Bouhafs-Aek/antenna-agent/examples/ti_pcb_antennas/README.md

# TI PCB antennas traced for KiCad (from the application notes)

Generated by `python scripts/ti_antennas.py examples/ti_pcb_antennas` (needs `pip install shapely matplotlib`). Each folder: `<name>.kicad_pcb`, Gerber `-F_Cu / -B_Cu / -Edge_Cuts`, `preview.png`.
The copper is the dimension table + figure of the note, rectangle by rectangle (see the top of `scripts/ti_antennas.py`). **TI itself says an exact copy needs its own Gerber/DXF from the reference design
(not provided): overlay TI's file on these before ordering; the dimensions here were read off the figures and tables and checked only by eye against the figure.**

| Folder | Note | Antenna | Substrate | Size (mm) | Main dimensions used |
|---|---|---|---|---|---|
| `an043_ifa_2g4` | AN043 (SWRA117D) | small meandered IFA, 2.4 GHz, VSWR < 2 over the ISM band (per the note) | thickness NOT given in the note (1.0 mm placeholder) | 15.2 x 5.7 (+ 20 mm ground placeholder) | L1 3.94 L2 2.70 L3 5.00 L4 2.64 L5 2.00 L6 4.90 W1 0.90 W2 0.50 D1 0.50 D2 0.30 D3 0.30 D4 0.50 D5 1.40 D6 1.70; ground on layer 2 |
| `dn023_ifa_868` | DN023 (SWRA228C) | inverted-F, 868 / 915 / 955 MHz | FR4 0.8 mm | board 45 x 31 ground + antenna 43 x 20 | L1 20 L2 5 L3 4 L4 10 L5 6 L6 17 (868: 9, 915: 1) L7 43 X 31 Y 45 W 1 W2 2; shorted leg + feed leg with a 1 mm gap to the ground (pi-network pads) |
| `dn024_mono_868` | DN024 (SWRA227E) | meandering monopole, 868 / 915 / 920 MHz or dual band 868 + 2440 MHz | FR4 1.6 mm | board 43 x 88 | L1 9 L2 18 L3 3 L4 38 L5 1 W 2 X1 63 X2 25 Y 43; copper on both layers |
| `an730_mono_bom` | SWRA730 | BOM-tunable meander monopole, 433-510 or 868-930 MHz, optionally + 2.4 GHz | FR4 1.6 mm | antenna 43 x 25, ground 30 mm placeholder | L1 16 L2 2 L3 24 L4 38 L5 7 L6 1.4 L7 3 W 2; Z64 gap (L2) bridged by 0 ohm copper |

Not in the traced set: the **AN058 (SWRA161B)** selection guide gives no dimension tables (it lists the reference designs; the Gerbers are in TI's reference-design zips).

## What is in each KiCad file
- Copper as zones with nets RF / GND (DN024, SWRA730) or as unnetted graphic copper polygons (AN043, DN023: the shorted leg ties RF and GND together in copper, so nets would be false).
- Lumped-port footprint `PORT_P1` (pad 1 RF on F.Cu, pad 2 GND): across the 1 mm gap to the ground edge (DN023, DN024), 1.4 mm (SWRA730), or on the feed pad over ground layer 2 (AN043).
- Edge.Cuts outline, stackup thickness in the file header, a note on the Cmts.User layer.

## Assumptions to check (not in the notes or read from a figure)
- AN043: PCB thickness, ground size, via position/size (0.6 / 0.3 mm placeholder under the via pad).
- DN023 / DN024 / SWRA730: ground-plane size below the antenna is a placeholder except DN023 (31 x 45) and DN024 (63 x 43, from the note). The CPW feed pocket and the pi/LC match (Z60-Z64) are not drawn; place the parts from the note.
- Bottom-layer copies of DN024 / SWRA730 are joined to the top by 2 placeholder vias (positions are my guess: the notes say only that the antenna is on both layers).
- Spacings in DN023's meander read from the figure at about +-0.5 mm; pitch 5.0 mm between legs, leg width 1.0 mm.
- None of these files was opened in KiCad or simulated here.
