Bouhafs-Aek/antenna-agent/docs/REFERENCE.md

# Reference paper

The antenna rebuilt and validated in this repository is the work of **Mohamed M. Gad and Mai O. Sallam**. This project
reproduces it for software validation; the antenna design is theirs. Please cite the paper if you use these examples.

**APA**
Gad, M. M., & Sallam, M. O. (2024). High gain antipodal meander line antenna for point-to-point WLAN/WiMAX applications. *Scientific Reports, 14*, 5769. https://doi.org/10.1038/s41598-024-54994-x

**BibTeX**
```bibtex
@article{gad2024meander,
  author  = {Gad, Mohamed M. and Sallam, Mai O.},
  title   = {High gain antipodal meander line antenna for point-to-point WLAN/WiMAX applications},
  journal = {Scientific Reports},
  volume  = {14},
  pages   = {5769},
  year    = {2024},
  doi     = {10.1038/s41598-024-54994-x},
  note    = {Open access, CC BY 4.0}
}
```

The paper is open access under CC BY 4.0 (https://creativecommons.org/licenses/by/4.0/). The unmodified PDF is in
`examples/gad_meander_replica/paper/`. Simulated numbers in this repository come from HFSS Student, not from the authors' data;
published values quoted here (band, directivity, measured gain) are theirs.

# Second reference: TI AN043 (IFA example)

A. Andersen, *Small Size 2.4 GHz PCB antenna*, Texas Instruments Application Note AN043, SWRA117D, 2008.
The antenna is TI's design (CC2511 USB dongle reference design). The PDF is not redistributed here.
```bibtex
@techreport{andersen2008an043,
  author      = {Andersen, Audun},
  title       = {Small Size 2.4 GHz PCB antenna},
  institution = {Texas Instruments},
  type        = {Application Note},
  number      = {AN043 (SWRA117D)},
  year        = {2008}
}
```
