Bouhafs-Aek/antenna-agent/examples/gad_meander_replica/results/report/report.html

# Report: examples

S11 minimum | -27.4 dB at 2.455 GHz
S11 < -10 dB band | 2.155-2.695 GHz
Worst S11 in 2.2-2.7 GHz | -9.1 dB at 2.700 GHz
Max VSWR in 2.2-2.7 GHz | 2.08
Input impedance at 2.450 GHz | 48 - 4j ohm
Gain at 2.2 GHz | 8.1 dBi (realised 7.8 dBi), peak at Theta 90 deg, Phi 82 deg
Gain at 2.45 GHz | 9.6 dBi (realised 9.6 dBi), peak at Theta 90 deg, Phi 90 deg
Gain at 2.7 GHz | 10.8 dBi (realised 10.3 dBi), peak at Theta 90 deg, Phi 90 deg
Radiation | patterns.csv missing: re-run the simulation with the current hfss_build.py

## S11 (dB)

## VSWR

## Input impedance

## Gain
