Bouhafs-Aek/antenna-agent/examples/gad_meander_b3_ro3003/s096/results/report/report.html

# Report: gad_meander_b3_ro3003

S11 minimum | -19.7 dB at 1.860 GHz
S11 < -10 dB band | 1.662-1.947 GHz ; 2.019-2.061 GHz
Worst S11 in 1.71-1.88 GHz | -10.6 dB at 1.710 GHz
Max VSWR in 1.71-1.88 GHz | 1.84
Input impedance at 1.794 GHz | 39 - 14j ohm
Gain at 1.71 GHz | 8.6 dBi (realised 8.2 dBi), peak at Theta 90 deg, Phi 82 deg
Gain at 1.795 GHz | 9.3 dBi (realised 9.1 dBi), peak at Theta 88 deg, Phi 88 deg
Gain at 1.88 GHz | 9.6 dBi (realised 9.6 dBi), peak at Theta 90 deg, Phi 90 deg
-3 dB beamwidth at 1.71 GHz (YZ / XY plane) | 94 deg / 58 deg
-3 dB beamwidth at 1.795 GHz (YZ / XY plane) | 86 deg / 56 deg
-3 dB beamwidth at 1.88 GHz (YZ / XY plane) | 80 deg / 54 deg

## S11 (dB)

## VSWR

## Input impedance

## Gain

## Radiation patterns (cuts)

## Gain over the whole sphere
