Bouhafs-Aek/antenna-agent/examples/gad_meander_b3_ro3003/s100/results/report/report.html

# Report: gad_meander_b3_ro3003

S11 minimum | -16.6 dB at 1.797 GHz
S11 < -10 dB band | 1.620-1.632 GHz ; 1.650-1.878 GHz ; 1.983-1.992 GHz
Worst S11 in 1.71-1.88 GHz | -10.1 dB at 1.878 GHz
Max VSWR in 1.71-1.88 GHz | 1.91
Input impedance at 1.794 GHz | 45 - 13j ohm
Gain at 1.71 GHz | 9.0 dBi (realised 8.8 dBi), peak at Theta 90 deg, Phi 88 deg
Gain at 1.795 GHz | 9.4 dBi (realised 9.3 dBi), peak at Theta 90 deg, Phi 90 deg
Gain at 1.88 GHz | 9.8 dBi (realised 9.4 dBi), peak at Theta 90 deg, Phi 90 deg
-3 dB beamwidth at 1.71 GHz (YZ / XY plane) | 90 deg / 58 deg
-3 dB beamwidth at 1.795 GHz (YZ / XY plane) | 84 deg / 56 deg
-3 dB beamwidth at 1.88 GHz (YZ / XY plane) | 78 deg / 52 deg

## S11 (dB)

## VSWR

## Input impedance

## Gain

## Radiation patterns (cuts)

## Gain over the whole sphere
