Bouhafs-Aek/antenna-agent/examples/gad_meander_b3_ro3003/s104/results/report/report.html

# Report: gad_meander_b3_ro3003

S11 minimum | -17.8 dB at 1.722 GHz
S11 < -10 dB band | 1.536-1.803 GHz
Worst S11 in 1.71-1.88 GHz | -7.6 dB at 1.863 GHz
Max VSWR in 1.71-1.88 GHz | 2.42
Input impedance at 1.794 GHz | 49 - 29j ohm
Gain at 1.71 GHz | 9.2 dBi (realised 9.2 dBi), peak at Theta 90 deg, Phi 90 deg
Gain at 1.795 GHz | 9.6 dBi (realised 9.2 dBi), peak at Theta 90 deg, Phi 90 deg
Gain at 1.88 GHz | 10.3 dBi (realised 9.6 dBi), peak at Theta 90 deg, Phi 90 deg
-3 dB beamwidth at 1.71 GHz (YZ / XY plane) | 86 deg / 56 deg
-3 dB beamwidth at 1.795 GHz (YZ / XY plane) | 80 deg / 52 deg
-3 dB beamwidth at 1.88 GHz (YZ / XY plane) | 70 deg / 48 deg

## S11 (dB)

## VSWR

## Input impedance

## Gain

## Radiation patterns (cuts)

## Gain over the whole sphere
