Bouhafs-Aek/antenna-agent/examples/gad_meander_fr4/b3/v100/results/report/report.html

# Report: b3

S11 minimum | -7.8 dB at 1.824 GHz
S11 < -10 dB band | none
Worst S11 in 1.71-1.88 GHz | -4.9 dB at 1.710 GHz
Max VSWR in 1.71-1.88 GHz | 3.67
Input impedance at 1.794 GHz | 23 - 18j ohm
Gain at 1.71 GHz | 8.0 dBi (realised 6.3 dBi), peak at Theta 90 deg, Phi 86 deg
Gain at 1.795 GHz | 8.8 dBi (realised 7.9 dBi), peak at Theta 90 deg, Phi 90 deg
Gain at 1.88 GHz | 9.0 dBi (realised 7.8 dBi), peak at Theta 90 deg, Phi 90 deg
-3 dB beamwidth at 1.71 GHz (YZ / XY plane) | 88 deg / 60 deg
-3 dB beamwidth at 1.795 GHz (YZ / XY plane) | 84 deg / 56 deg
-3 dB beamwidth at 1.88 GHz (YZ / XY plane) | 78 deg / 54 deg

## S11 (dB)

## VSWR

## Input impedance

## Gain

## Radiation patterns (cuts)

## Gain over the whole sphere
