Bouhafs-Aek/antenna-agent/examples/gad_meander_fr4/replica/iter1_lambda_g/results/report/report.html

# Report: replica

S11 minimum | -11.2 dB at 2.660 GHz
S11 < -10 dB band | 2.620-2.705 GHz ; 2.810-2.835 GHz
Worst S11 in 2.2-2.7 GHz | -3.9 dB at 2.200 GHz
Max VSWR in 2.2-2.7 GHz | 4.52
Input impedance at 2.450 GHz | 22 - 31j ohm
Gain at 2.2 GHz | 4.5 dBi (realised 2.3 dBi), peak at Theta 88 deg, Phi 88 deg
Gain at 2.45 GHz | 7.8 dBi (realised 6.3 dBi), peak at Theta 88 deg, Phi 86 deg
Gain at 2.7 GHz | 9.2 dBi (realised 8.8 dBi), peak at Theta 90 deg, Phi 90 deg
-3 dB beamwidth at 2.2 GHz (YZ / XY plane) | 86 deg / 68 deg
-3 dB beamwidth at 2.45 GHz (YZ / XY plane) | 86 deg / 60 deg
-3 dB beamwidth at 2.7 GHz (YZ / XY plane) | 74 deg / 54 deg

## S11 (dB)

## VSWR

## Input impedance

## Gain

## Radiation patterns (cuts)

## Gain over the whole sphere
