Bouhafs-Aek/antenna-agent/examples/gad_meander_fr4/replica_matched/v100/preview.png

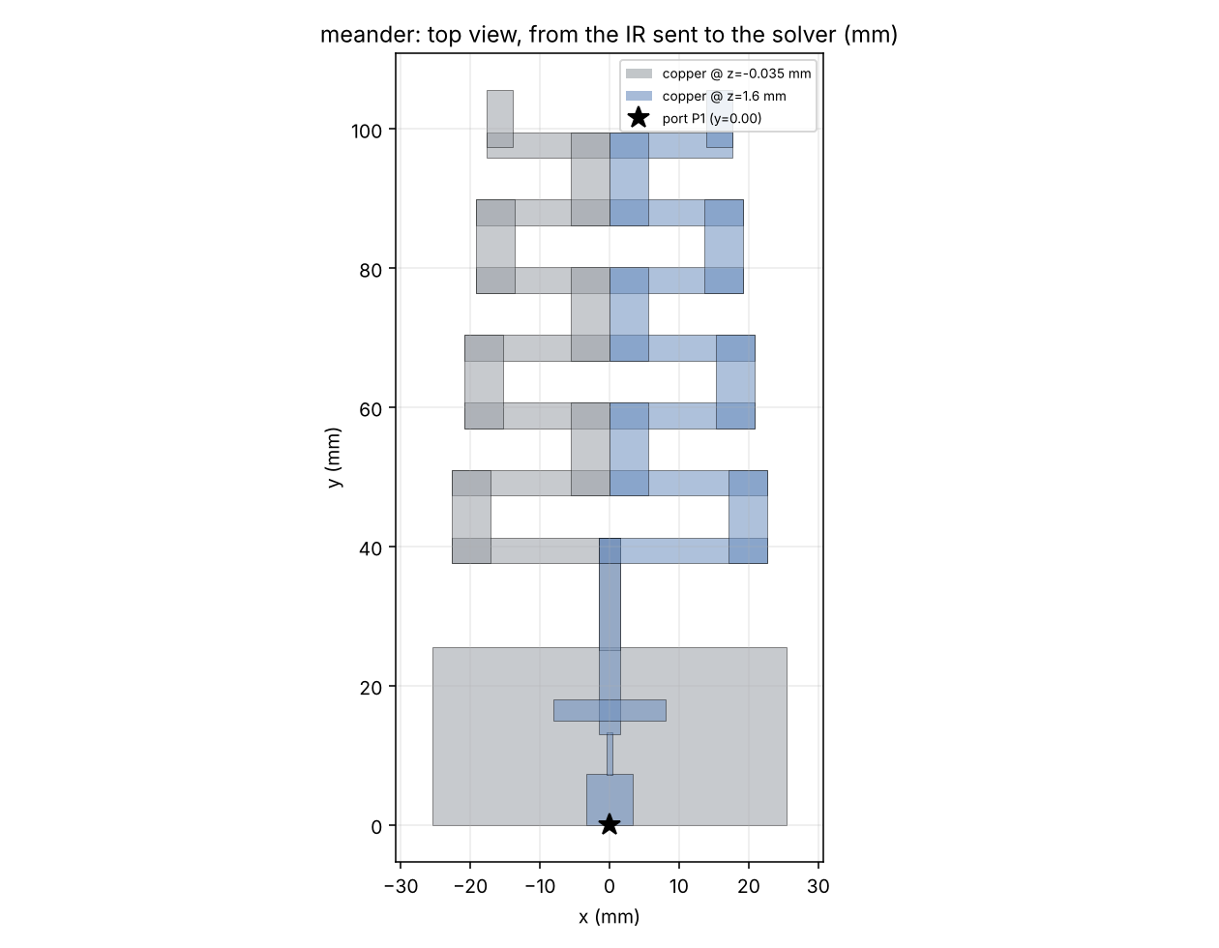
examples/gad_meander_fr4/replica_matched/v100/preview.png
