Bouhafs-Aek/antenna-agent/examples/ti_pcb_antennas/an043_ifa_2g4/preview.png

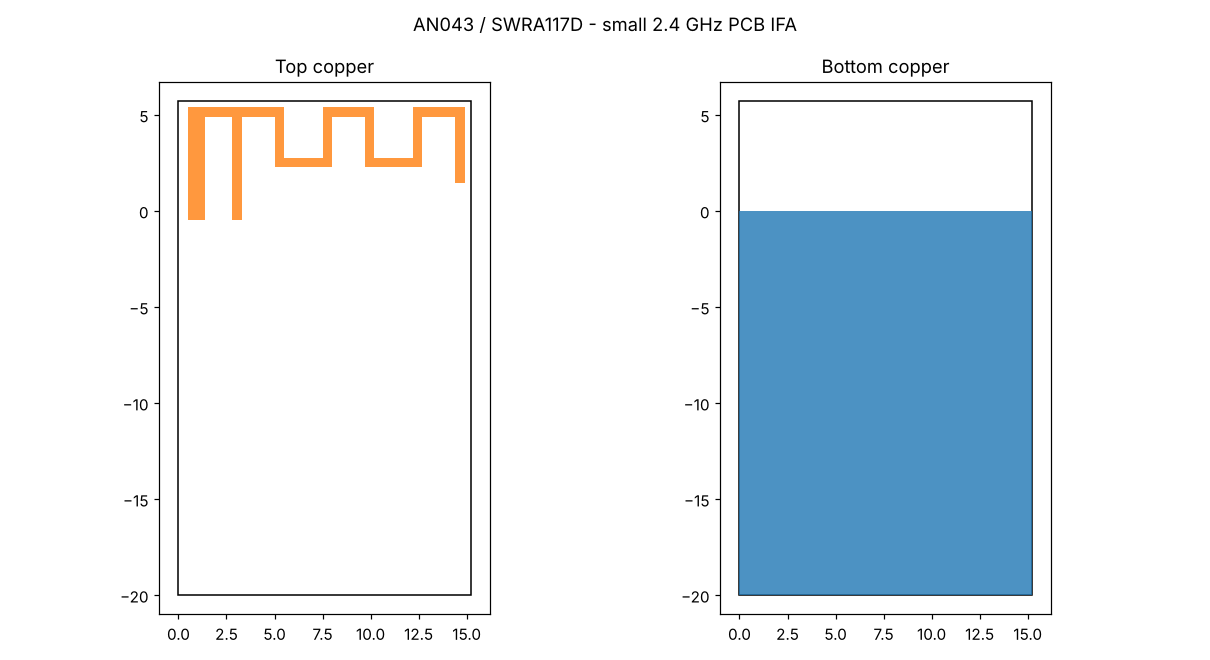
examples/ti_pcb_antennas/an043_ifa_2g4/preview.png
