Bouhafs-Aek/antenna-agent/examples/ti_pcb_antennas/dn023_ifa_868/preview.png

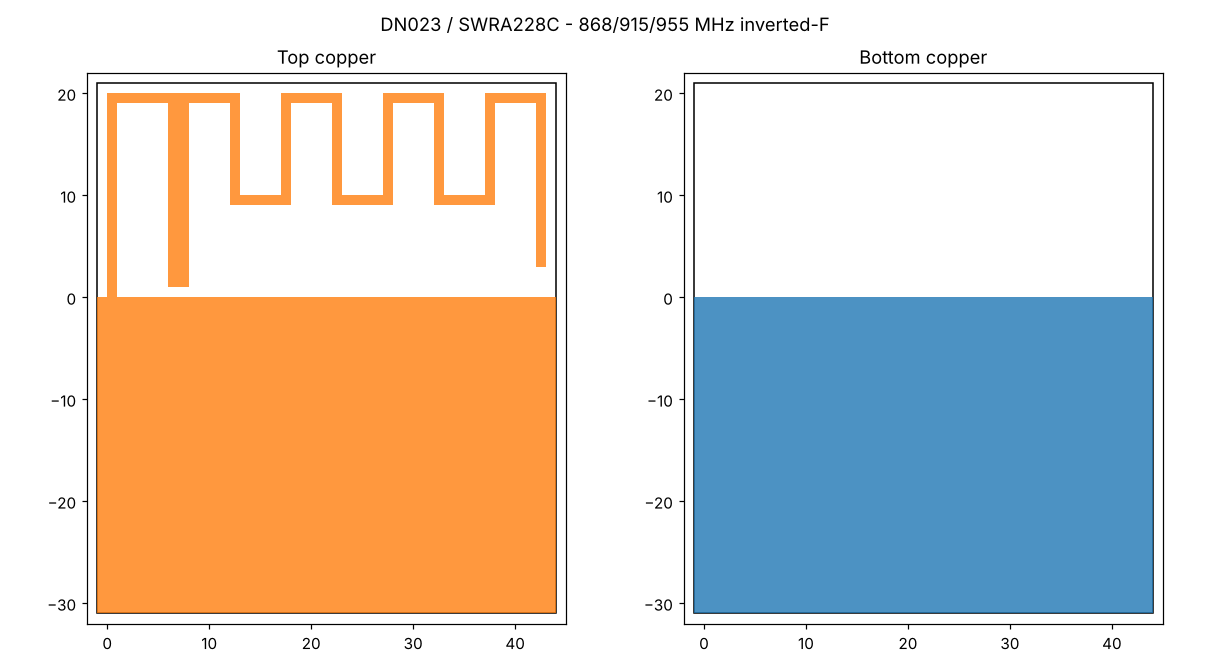
examples/ti_pcb_antennas/dn023_ifa_868/preview.png
