Bouhafs-Aek/antenna-agent/examples/ti_pcb_antennas/dn024_mono_868/preview.png

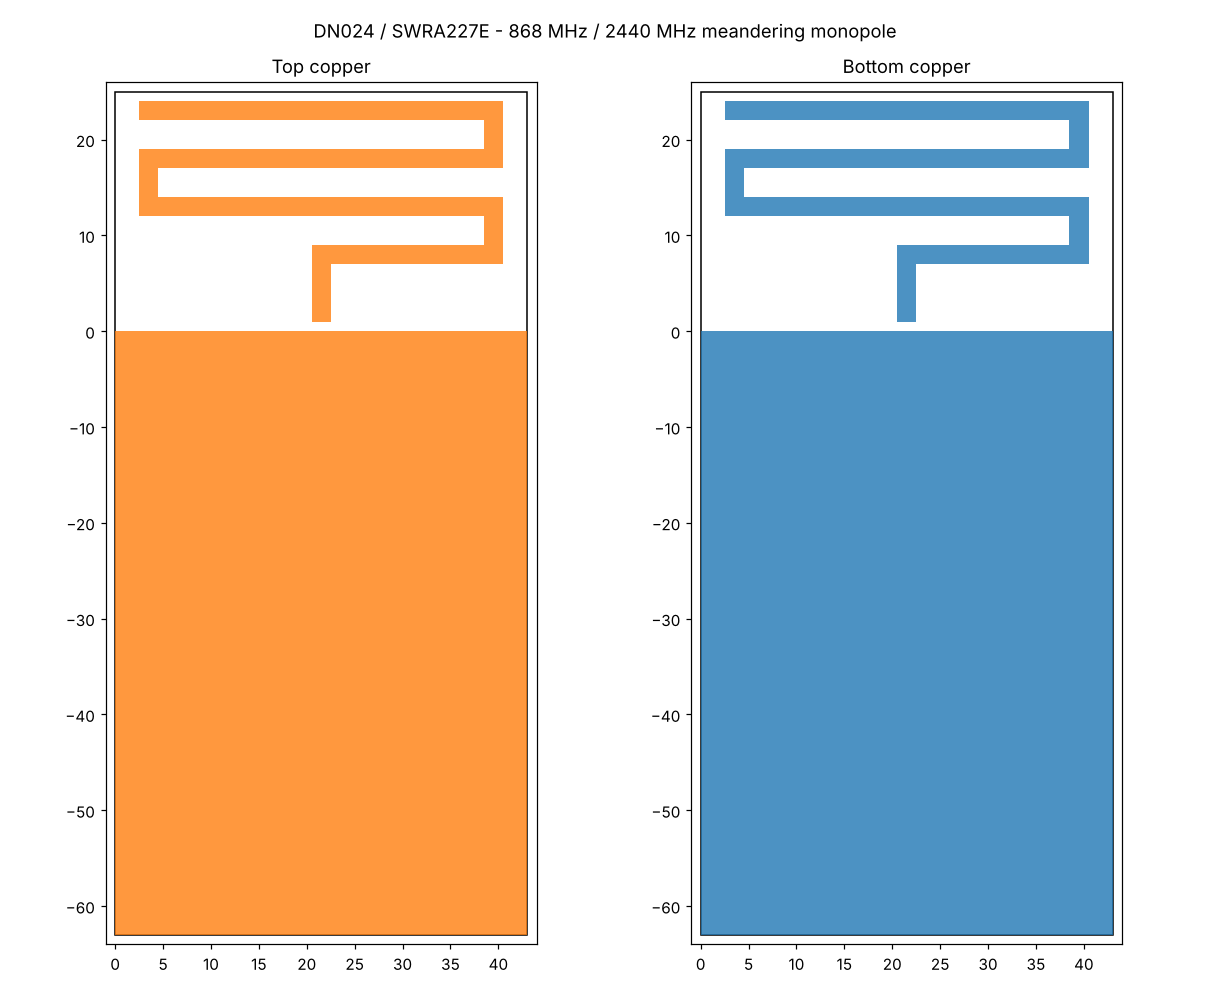
examples/ti_pcb_antennas/dn024_mono_868/preview.png
