Bouhafs-Aek/antenna-agent/examples/ti_pcb_antennas/an730_mono_bom/preview.png

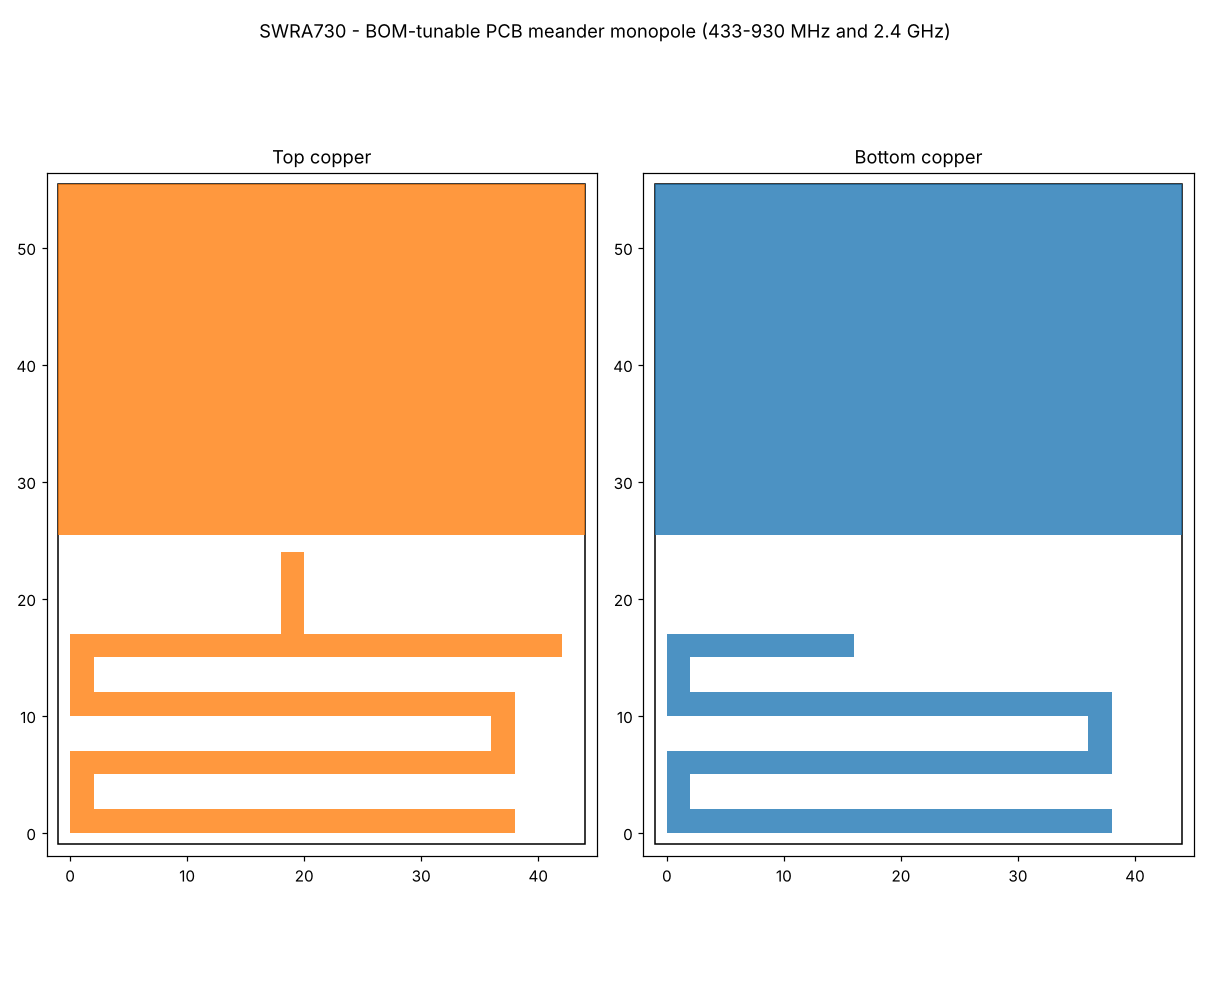
examples/ti_pcb_antennas/an730_mono_bom/preview.png
