Bouhafs-Aek/antenna-agent/examples/gad_meander_fr4/b3_matched/fabrication/board.dxf

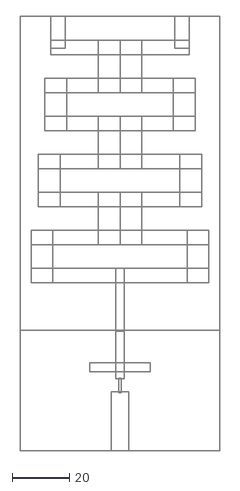
[picture p6: CAD file, 2026-11-05]
examples/gad_meander_fr4/b3_matched/fabrication/board.dxf
69.6 x 151.5
