Bouhafs-Aek/antenna-agent/examples/gad_meander_fr4/b3_matched/fabrication/preview.png

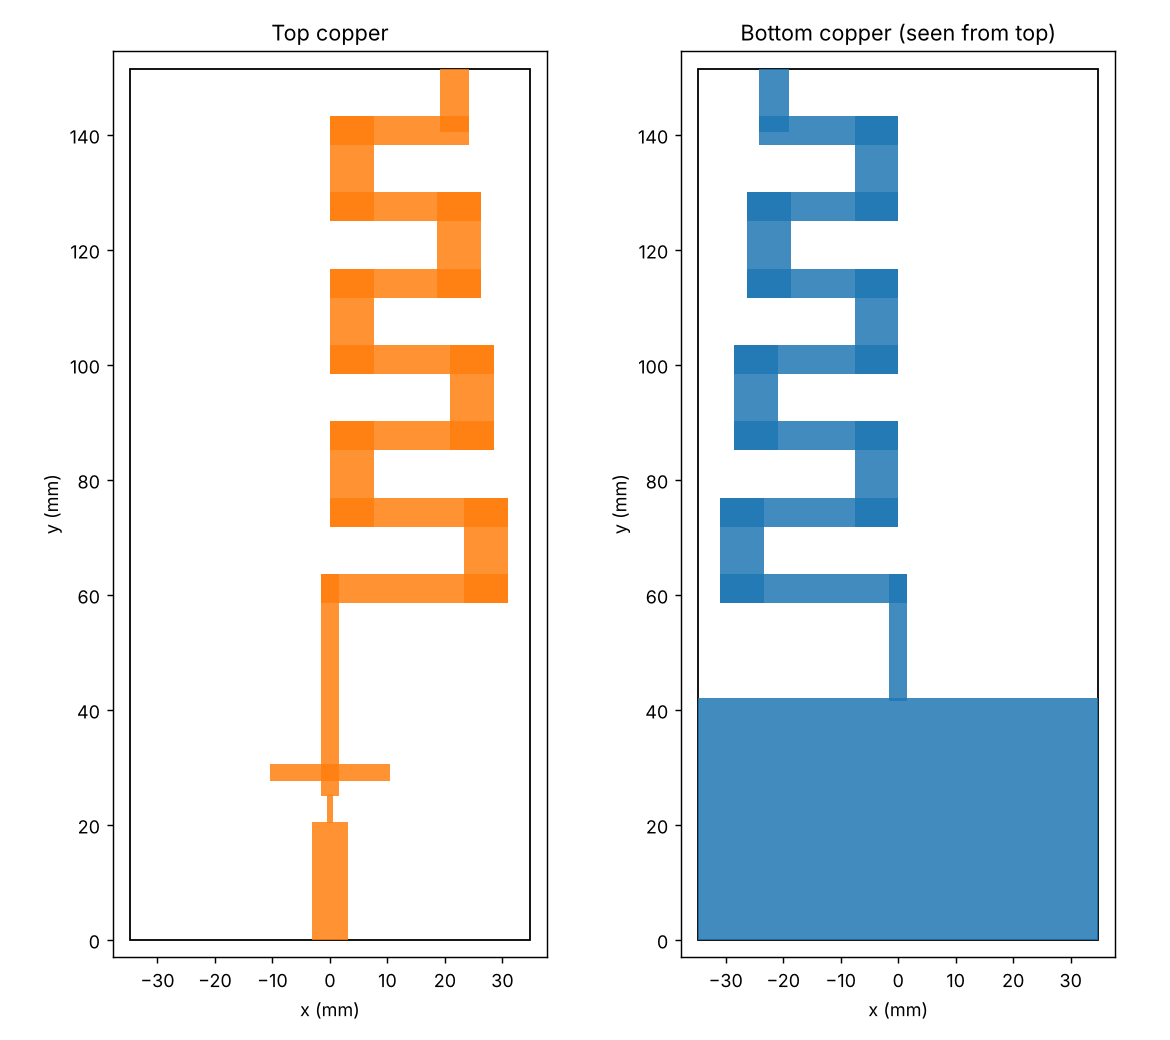
examples/gad_meander_fr4/b3_matched/fabrication/preview.png
