Bouhafs-Aek/antenna-agent/examples/gad_meander_b3_ro3003/s096/results/gain.csv

f_GHz | peak_gain_dBi | theta_deg | phi_deg
1.71 | 8.576645165454767 | 90.0 | 82.0
1.795 | 9.298604119118307 | 88.0 | 88.0
1.88 | 9.631487124292812 | 90.0 | 90.0
