Bouhafs-Aek/antenna-agent/examples/gad_meander_b3_ro3003/s096/results/patterns.csv

f_GHz | theta_deg | phi_deg | gain_dBi
1.71 | 0.0 | 0.0 | -6.793407713370287
1.71 | 2.0 | 0.0 | -6.86757682565839
1.71 | 4.0 | 0.0 | -6.936700160204787
1.71 | 6.0 | 0.0 | -7.000442982731564
1.71 | 8.0 | 0.0 | -7.058510179453257
1.71 | 10.0 | 0.0 | -7.1106502750213165
1.71 | 12.0 | 0.0 | -7.156658949891291
1.71 | 14.0 | 0.0 | -7.196381950194751
1.71 | 16.0 | 0.0 | -7.229717297328437
1.71 | 18.0 | 0.0 | -7.25661672184084
1.71 | 20.0 | 0.0 | -7.277086265526669
1.71 | 22.0 | 0.0 | -7.291186016016374
1.71 | 24.0 | 0.0 | -7.299028959098129
1.71 | 26.0 | 0.0 | -7.3007789554491165
1.71 | 28.0 | 0.0 | -7.29664787049526
1.71 | 29.999999999999996 | 0.0 | -7.2868919088286805
1.71 | 32.0 | 0.0 | -7.2718072277689485
1.71 | 34.0 | 0.0 | -7.251724927597449
1.71 | 36.0 | 0.0 | -7.22700553759989
1.71 | 38.0 | 0.0 | -7.19803313584484
1.71 | 40.0 | 0.0 | -7.165209254998218
1.71 | 42.0 | 0.0 | -7.12894673495497
1.71 | 44.0 | 0.0 | -7.089663684593432
1.71 | 46.0 | 0.0 | -7.047777709046984
1.71 | 48.0 | 0.0 | -7.003700545749091
1.71 | 50.0 | 0.0 | -6.957833233001746
1.71 | 52.0 | 0.0 | -6.910561910337569
1.71 | 54.0 | 0.0 | -6.862254322228924
1.71 | 56.0 | 0.0 | -6.813257067608385
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
