Bouhafs-Aek/antenna-agent/examples/gad_meander_b3_ro3003/s096/results/s11.csv

f_GHz | re | im
1.5 | -0.283187804793575 | 0.794306537747741
1.503 | -0.2601575776386989 | 0.796594497086235
1.506 | -0.23679422751459514 | 0.798123588078676
1.509 | -0.21312372395482448 | 0.7988607201535388
1.512 | -0.1891750241127095 | 0.7987731115211848
1.515 | -0.16498019203438247 | 0.7978285423066226
1.518 | -0.1405744993589908 | 0.7959956331600246
1.521 | -0.11599650337084913 | 0.7932441486688767
1.524 | -0.09128809815906101 | 0.789545324298987
1.527 | -0.0664945345516454 | 0.78487221492667
1.53 | -0.041664404501771606 | 0.779200062300183
1.533 | -0.016849585731525236 | 0.7725066779982269
1.536 | 0.007894857299769072 | 0.7647728376549118
1.539 | 0.03251081962569237 | 0.7559826814166897
1.542 | 0.056937352154917555 | 0.746124114814739
1.545 | 0.08111091042417864 | 0.7351892035076306
1.548 | 0.1049656570405685 | 0.7231745547087632
1.551 | 0.1284338180732252 | 0.710081677598355
1.554 | 0.15144609245395124 | 0.6959173146685249
1.557 | 0.17393211212803644 | 0.6806937357990936
1.56 | 0.1958209492947762 | 0.6644289869446555
1.563 | 0.2170416656348741 | 0.6471470856578843
1.566 | 0.23752389698973178 | 0.6288781563000141
1.569 | 0.2571984655931181 | 0.6096584987064205
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
