Bouhafs-Aek/antenna-agent/examples/gad_meander_b3_ro3003/s100/results/gain.csv

f_GHz | peak_gain_dBi | theta_deg | phi_deg
1.71 | 9.04612847329499 | 90.0 | 88.0
1.795 | 9.444550743746415 | 90.0 | 90.0
1.88 | 9.843175874219058 | 90.0 | 90.0
