Bouhafs-Aek/antenna-agent/examples/gad_meander_b3_ro3003/s100/results/patterns.csv

f_GHz | theta_deg | phi_deg | gain_dBi
1.71 | 0.0 | 0.0 | -8.05858006344969
1.71 | 2.0 | 0.0 | -8.044694729586785
1.71 | 4.0 | 0.0 | -8.032354516383936
1.71 | 6.0 | 0.0 | -8.021512324799266
1.71 | 8.0 | 0.0 | -8.012098510982929
1.71 | 10.0 | 0.0 | -8.004024339294274
1.71 | 12.0 | 0.0 | -7.99718579309976
1.71 | 14.0 | 0.0 | -7.991467590197279
1.71 | 16.0 | 0.0 | -7.986747229471493
1.71 | 18.0 | 0.0 | -7.982898884508673
1.71 | 20.0 | 0.0 | -7.979796961459218
1.71 | 22.0 | 0.0 | -7.977319154375479
1.71 | 24.0 | 0.0 | -7.975348861925663
1.71 | 26.0 | 0.0 | -7.973776873308398
1.71 | 28.0 | 0.0 | -7.9725022850588605
1.71 | 29.999999999999996 | 0.0 | -7.971432669416827
1.71 | 32.0 | 0.0 | -7.970483573230309
1.71 | 34.0 | 0.0 | -7.969577477979605
1.71 | 36.0 | 0.0 | -7.968642390976523
1.71 | 38.0 | 0.0 | -7.967610260958003
1.71 | 40.0 | 0.0 | -7.966415415811076
1.71 | 42.0 | 0.0 | -7.964993205788375
1.71 | 44.0 | 0.0 | -7.9632790041346695
1.71 | 46.0 | 0.0 | -7.961207672176938
1.71 | 48.0 | 0.0 | -7.958713542578621
1.71 | 50.0 | 0.0 | -7.955730918263128
1.71 | 52.0 | 0.0 | -7.9521950311579594
1.71 | 54.0 | 0.0 | -7.948043359513819
1.71 | 56.0 | 0.0 | -7.943217169149351
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
