Bouhafs-Aek/antenna-agent/examples/gad_meander_b3_ro3003/s100/results/s11.csv

f_GHz | re | im
1.5 | 0.206087974399971 | 0.671218042492628
1.503 | 0.22854295085244336 | 0.6535944670969008
1.506 | 0.2502384015975304 | 0.6349060008441038
1.509 | 0.2710982304192784 | 0.615191868068537
1.512 | 0.29104867441446775 | 0.5944982388885252
1.515 | 0.3100190500798406 | 0.5728780752528103
1.518 | 0.32794248697083833 | 0.5503908831523019
1.521 | 0.3447566348236626 | 0.5271023723560873
1.524 | 0.36040433015606915 | 0.5030840275259386
1.527 | 0.3748342089678589 | 0.478412597069656
1.53 | 0.3880012532551856 | 0.45316950851482246
1.533 | 0.39986726061837385 | 0.42744022142617205
1.536 | 0.4104012282466123 | 0.40131353086339866
1.539 | 0.4195796449536694 | 0.3748808360056461
1.542 | 0.42738668765440435 | 0.3482353897946724
1.545 | 0.4338143216459162 | 0.3214715462303526
1.548 | 0.4388623072275186 | 0.29468402227006896
1.551 | 0.442538118512838 | 0.2679671911369567
1.554 | 0.44485678373461335 | 0.2414144232425525
1.557 | 0.44584065993748967 | 0.2151174898931802
1.56 | 0.44551915877122006 | 0.18916604347805147
1.563 | 0.4439284442836333 | 0.1636471858926555
1.566 | 0.4411111284081402 | 0.13864513441433154
1.569 | 0.4371159955925332 | 0.11424099085107312
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
