Bouhafs-Aek/antenna-agent/examples/gad_meander_fr4/b3_matched/fabrication/kicad/b3_matched.kicad_sch

## KiCad design examples/gad_meander_fr4/b3_matched/fabrication/kicad/b3_matched.kicad_sch (2026-11-05)

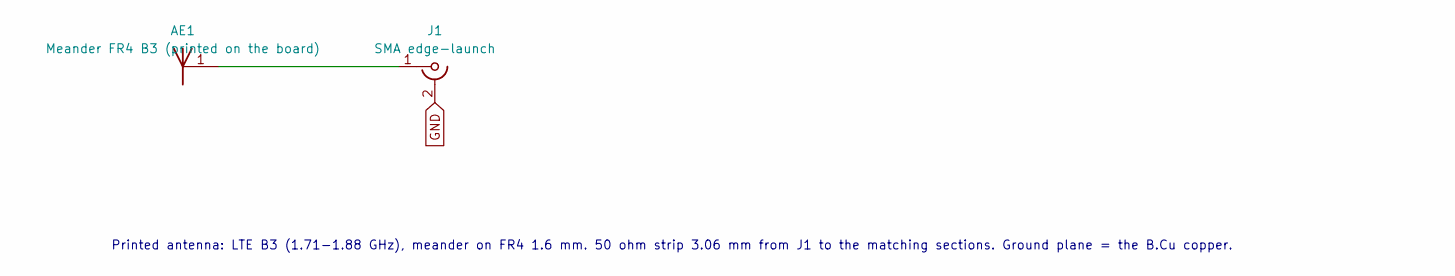
[picture p8: schematic b3_matched.kicad_sch]

Parts:
AE1: Meander FR4 B3 (printed on the board)
J1: SMA edge-launch

Connections:
GND: J1.2 (Ext)
unnamed: AE1.1, J1.1 (In)

Notes on the sheet:
Printed antenna: LTE B3 (1.71-1.88 GHz), meander on FR4 1.6 mm. 50 ohm strip 3.06 mm from J1 to the matching sections. Ground plane = the B.Cu copper.
