Bouhafs-Aek/antenna-agent/(commit log)

2026-10-11 Initial release
    [s11.csv]
2026-10-11 Initial release: HFSS only, PDF workflow, worked examples with real results
    [gain.csv, s11.csv]
2026-11-03 Clean repo: keep Gad & Sallam replica and LTE B3 meander with HFSS results; add Claude/PDF guide
    Claude-Session: https://claude.ai/code/session_014zphL6cUuPEx1k6FY6vCN3
    [gain.csv, patterns.csv, s11.csv]
2026-11-03 HFSS attach: fall back to COM ProgID when the Windows COM table is unreadable (E_OUTOFMEMORY); regenerate scripts
    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
2026-11-03 HFSS attach: ProgID path first, 90 s watchdog; regenerate scripts
    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
2026-11-03 HFSS attach: proven COM-table path first, ProgID path on 2nd try, 60 s watchdog
    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
2026-11-03 HFSS attach: direct ROT moniker lookup (no enumeration); drop ProgID route (invalid on Student)
    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
2026-11-03 FR4: first run result (f_res 2.66 GHz, mistuned), corrected scale 0.925 for replica and B3
    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
    [gain.csv, patterns.csv, s11.csv]
2026-11-04 FR4 B3 with SMA end-launch (3 scales), run_fr4 -Case b3_sma, path to fabrication
    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
2026-11-04 FR4 B3 ideal-port result (no -10 dB band, Zin 23-j18), matched variant generated
    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
    [gain.csv, patterns.csv, s11.csv]
2026-11-04 run_fr4.ps1: allow -Case b3_matched
    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
2026-11-04 match: add sections in series (feed/board/ground grow by their length); record failed iteration 1; regenerate b3_matched
    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
    [gain.csv, patterns.csv, s11.csv]
2026-11-04 SMA: PEC back-stop behind the coax wave port (HFSS validation error), readable solver messages, stop retry on validation error, new case b3_matched_sma
    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
2026-11-05 Final: remove SMA cases, record FR4 b3_matched (retained) and b3_final results, status table, fabrication path
    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
    [gain.csv, patterns.csv, s11.csv]
2026-11-05 Fabrication export for b3_matched (Gerber top/bottom/outline, DXF, preview, fab sheet) + scripts/export_fab.py
    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
    [board.dxf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]
2026-11-05 FR4 replica v100 results archived; replica_matched case (sections from the real S11, predicted -11.3 dB over 2.2-2.7 GHz)
    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
    [gain.csv, patterns.csv, s11.csv]
2026-11-05 KiCad export for b3_matched: .kicad_pcb + KiCad-style Gerber X2 (F_Cu, B_Cu, Edge_Cuts)
    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
    [b3_matched.kicad_pcb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]
2026-11-05 KiCad schematic + project for b3_matched
    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
    [b3_matched.kicad_sch]
2026-11-05 KiCad PCB: simulation port footprint (RF/GND pads), nets, zones, stackup
    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
    [b3_matched.kicad_pcb]
2026-11-05 TI PCB antennas traced for KiCad: AN043 IFA 2.4 GHz, DN023 IFA 868, DN024 monopole 868/2440, SWRA730 BOM-tunable monopole
    [an043_ifa_2g4.kicad_pcb, an730_mono_bom.kicad_pcb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]
